Sakura-IT/AmiExtFDD/README.md

Interface to connect floppy drives to Amiga, externally.
