Sakura-IT/AmiExtFDD/board/1.0/AmiExtFDD.pdf

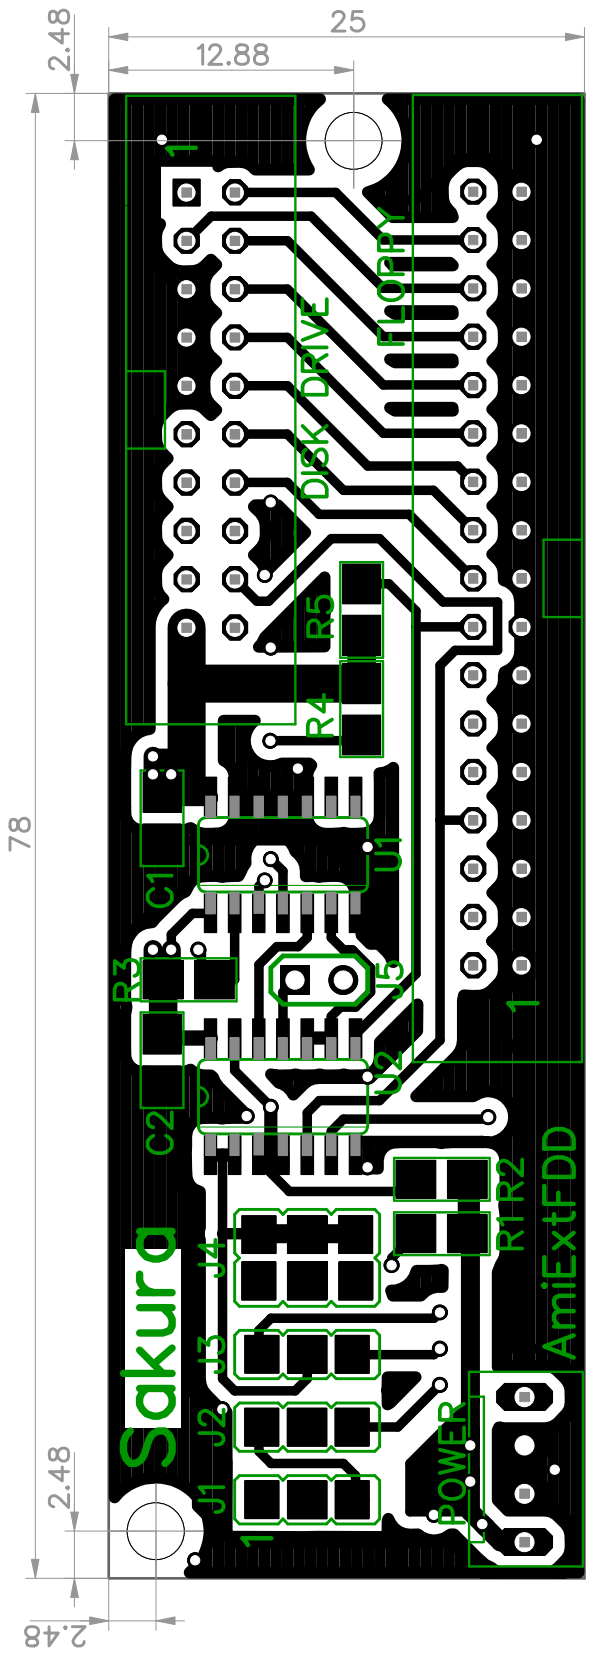
[picture p5: page 1]
