Sakura-IT/AmiExtFDD/(list of files, drawings)

Other design files:
board/1.0/AmiExtFDD.dch
board/1.0/AmiExtFDD.dip
