Sakura-IT/AmiExtFDD/board/1.0/AmiExtFDD.brd

## EAGLE design board/1.0/AmiExtFDD.brd (2015-06-01)

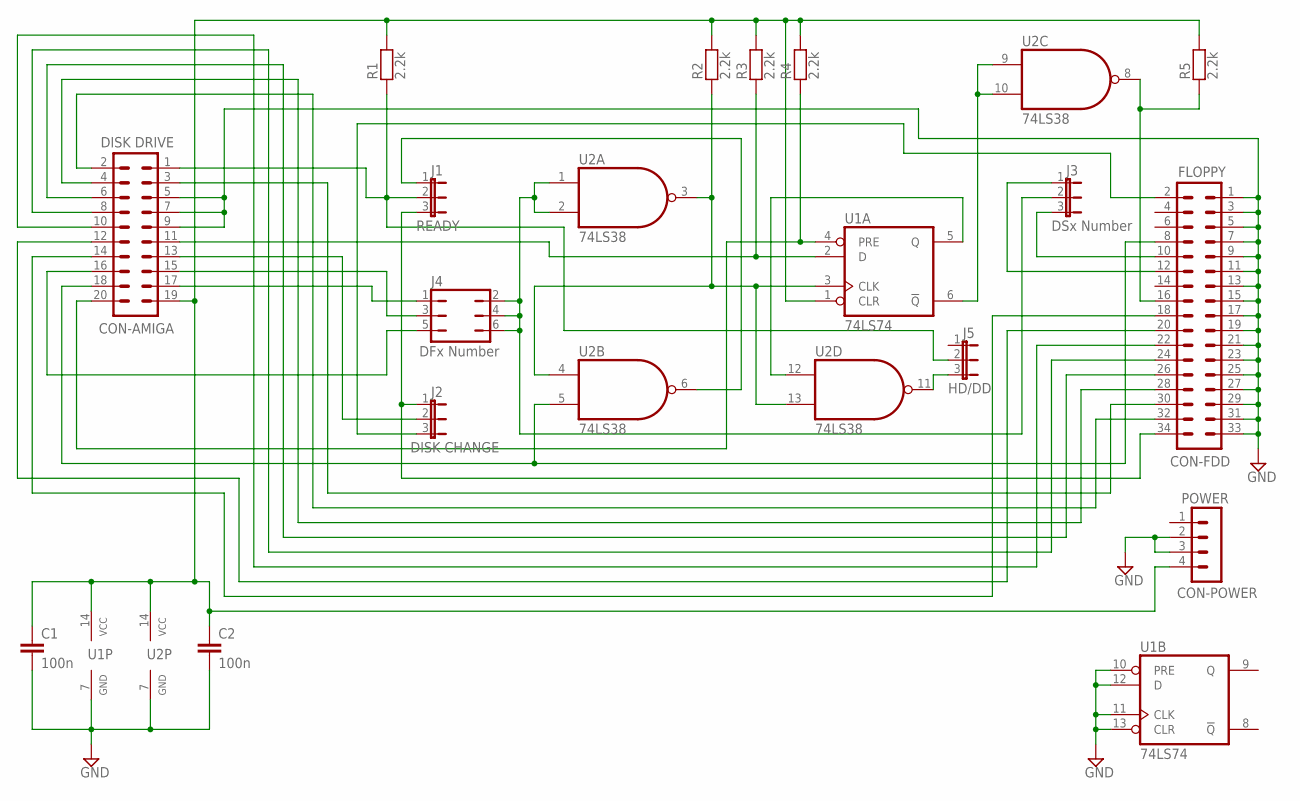
[picture p6: schematic AmiExtFDD.sch]

Parts:
C1, C2: 100n; SMD-UNI
CON-AMIGA: DISK DRIVE; IDC20
CON-FDD: FLOPPY; FDD2
CON-POWER: POWER; MINI-MOLEX
J1: READY; JP3X1-UNI
J2: DISK CHANGE; JP3X1-UNI
J3: DSx Number; JP3X1-UNI
J4: DFx Number; JP3X2-UNI
J5: HD/DD; JP3X1-UNI
R1, R2, R3, R4, R5: 2.2k; SMD-UNI
U1: 74LS74; SO14
U2: 74LS38; SO14

Connections:
1: CON-POWER.1
GND: C1.2, C2.2, CON-AMIGA.5, CON-AMIGA.7, CON-AMIGA.9, CON-FDD.1, CON-FDD.3, CON-FDD.5, CON-FDD.7, CON-FDD.9, CON-FDD.11, CON-FDD.13, CON-FDD.15, CON-FDD.17, CON-FDD.19, CON-FDD.21, CON-FDD.23, CON-FDD.25, CON-FDD.27, CON-FDD.29, CON-FDD.31, CON-FDD.33, CON-POWER.2, CON-POWER.3, U1.7 (GND), U1.10 (PRE), U1.11 (CLK), U1.12 (D), U1.13 (CLR), U2.7 (GND)
unnamed: CON-AMIGA.13, J2.2
unnamed: U1.5 (Q), U2.12 (I0)
unnamed: CON-FDD.16, R5.1, U2.8 (O)
unnamed: U1.6 (!Q), U2.9 (I0), U2.10 (I1)
unnamed: R2.1, U1.3 (CLK), U2.3 (O), U2.4 (I0), U2.13 (I1)
unnamed: J5.3, U2.11 (O)
unnamed: CON-AMIGA.17, J4.1
unnamed: CON-FDD.34, J1.3, J2.1
unnamed: CON-FDD.2, J2.3
unnamed: J1.1, U2.6 (O)
unnamed: CON-AMIGA.1, J1.2, J5.2, R1.1
unnamed: CON-AMIGA.15, J4.3
unnamed: CON-FDD.12, J3.1
unnamed: CON-AMIGA.16, J4.5
unnamed: J3.2, J4.2, J4.4, J4.6, U2.1 (I0), U2.2 (I1)
unnamed: CON-AMIGA.18, CON-FDD.8, U2.5 (I1)
unnamed: CON-FDD.10, J3.3
unnamed: CON-AMIGA.3, CON-FDD.30
unnamed: CON-AMIGA.11, R3.1, U1.2 (D)
unnamed: C1.1, C2.1, CON-AMIGA.19, CON-POWER.4, R1.2, R2.2, R3.2, R4.2, R5.2, U1.1 (CLR), U1.14 (VCC), U2.14 (VCC)
unnamed: CON-AMIGA.4, CON-FDD.28
unnamed: CON-AMIGA.6, CON-FDD.26
unnamed: CON-AMIGA.2, CON-FDD.32
unnamed: CON-AMIGA.8, CON-FDD.24
unnamed: CON-AMIGA.10, CON-FDD.22
unnamed: CON-AMIGA.12, CON-FDD.20
unnamed: CON-AMIGA.14, CON-FDD.18
unnamed: CON-AMIGA.20, R4.1, U1.4 (PRE)

Board: 2 copper layers, 17 parts (0 on the bottom side), 29 nets, no tracks yet.
