Sakura-IT/AmiExtFDD/(threads)

Thread 1 (2021-06-11):

need help

Rezamjj, 2021-06-11:
Hello sir
I have read about your project and I really enjoy it.
I want to make the board but I want to add 2 LED on it, A green LED for Power and a blinking LED as a sign of using the board(reading or writing). can you please help me how to do this?
