Sakura-IT/AmiExtFDD/(commit log)

2014-11-23 Commit revision 1.0 of the board.
    [AmiExtFDD.brd, AmiExtFDD.dch, AmiExtFDD.dip, AmiExtFDD.sch]
2014-12-09 Minor fixes to power traces.
    [AmiExtFDD.dip]
2015-01-02 Fix missing RDY connection.
    [AmiExtFDD.sch]
2015-01-07 Gerber file of board
    [AmiExtFDD.brd, AmiExtFDD.dip, AmiExtFDD.sch]
2015-01-30 Little change on board and scheme
    [AmiExtFDD.dip, AmiExtFDD.sch]
2015-06-01 final version of board
    [AmiExtFDD.brd, AmiExtFDD.dip, AmiExtFDD.sch]
